KURANADO2/traffic_light/(commit log)

2026-06-26 docs: add claude traffic light project
    Document the ESP32-C3 traffic light build, including corrected L1/L2/L3 wiring, soldering process images, firmware usage, Claude Code hook setup, and troubleshooting notes.
    Add the Arduino firmware, Claude Code bridge scripts, hook installer, example hook configuration, build media, and repository ignore rules.
    Verification:
    - Ran python3 -m py_compile scripts/claude_traffic_light.py scripts/install_claude_hooks.py.
    - Ran jq empty claude-hooks.example.json.
    - Verified README local image and video links resolve.
    [traffic_light_test.ino]
2026-06-27 docs: 删除未用到的视频
